el-nikitos/UAH/документация/ИД.png

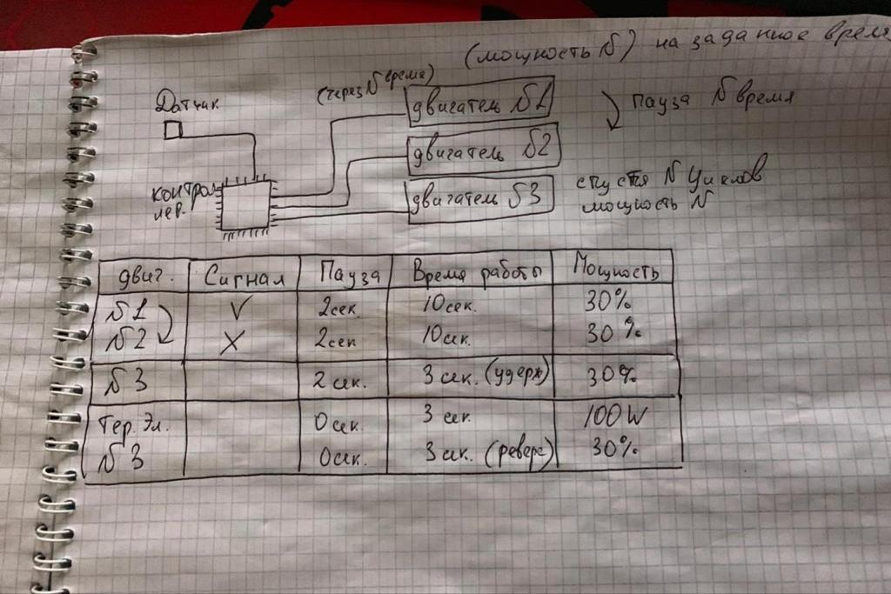
документация/ИД.png
