el-nikitos/UAH/UAH_0/PNG/UAH_0A_B.png

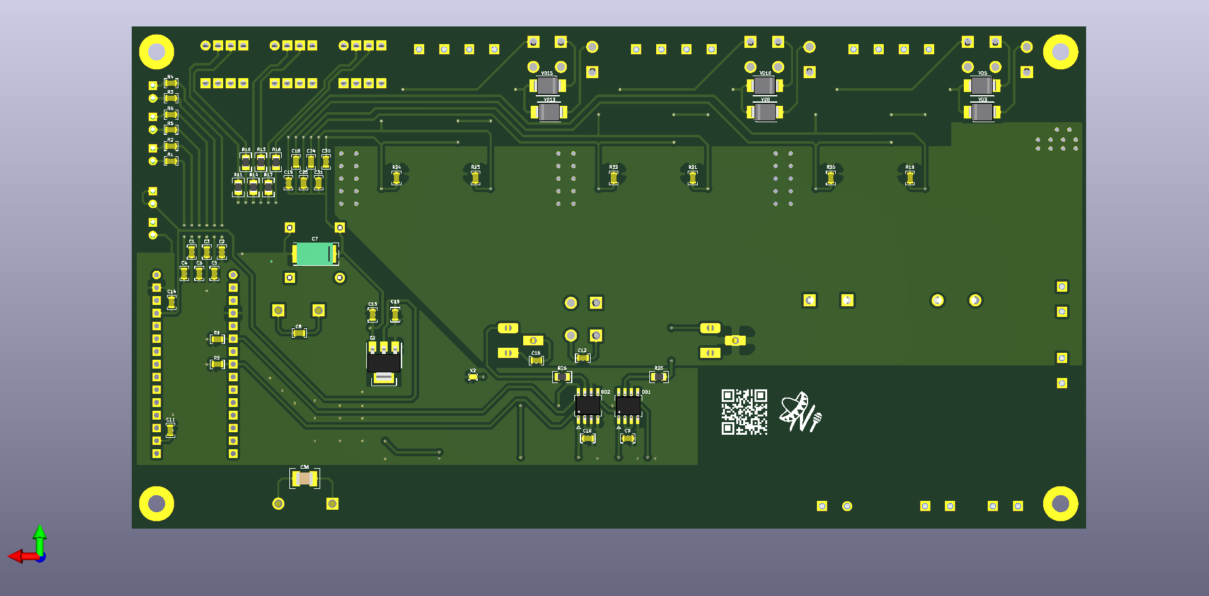
UAH_0/PNG/UAH_0A_B.png
