el-nikitos/UAH/UAH_0/PNG/UAH_0A_F.png

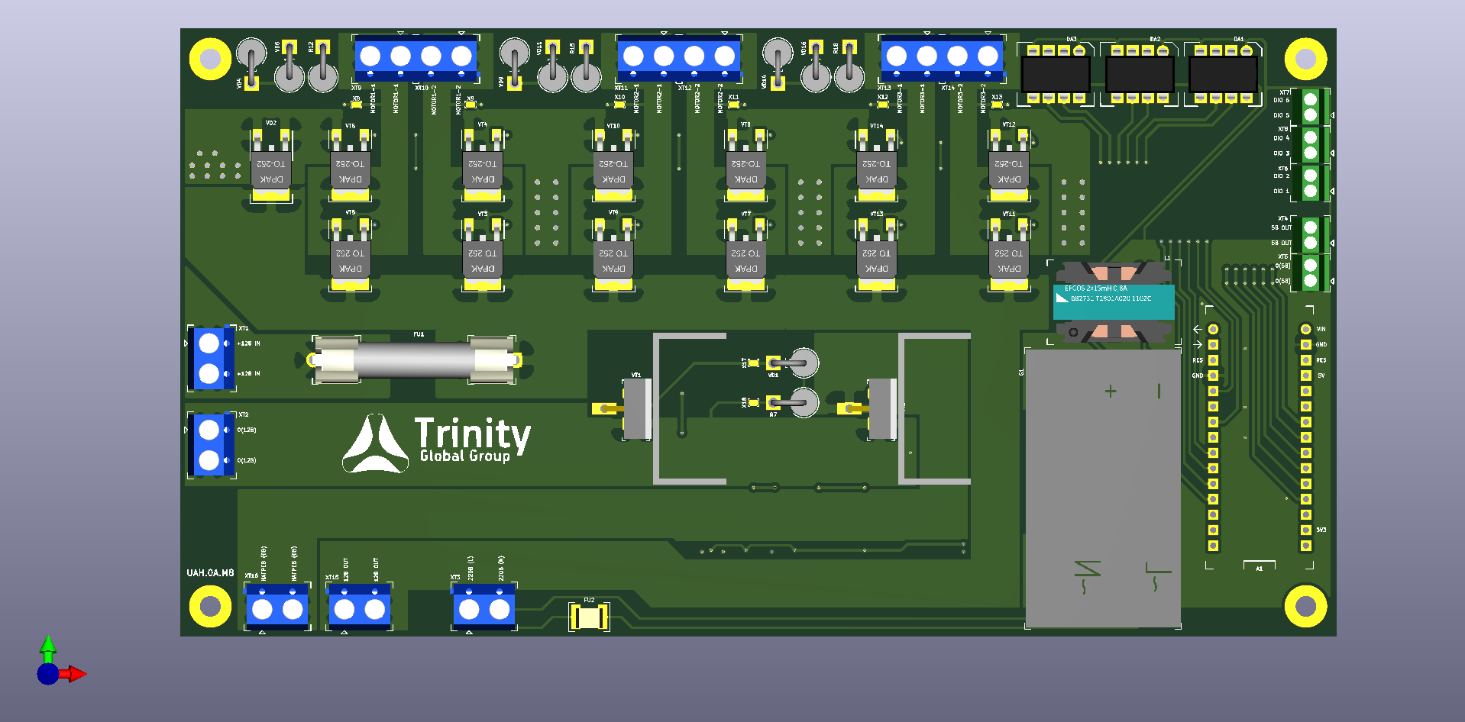
UAH_0/PNG/UAH_0A_F.png
