el-nikitos/UAH/UAH_0/PDF/UAH_0B.pdf

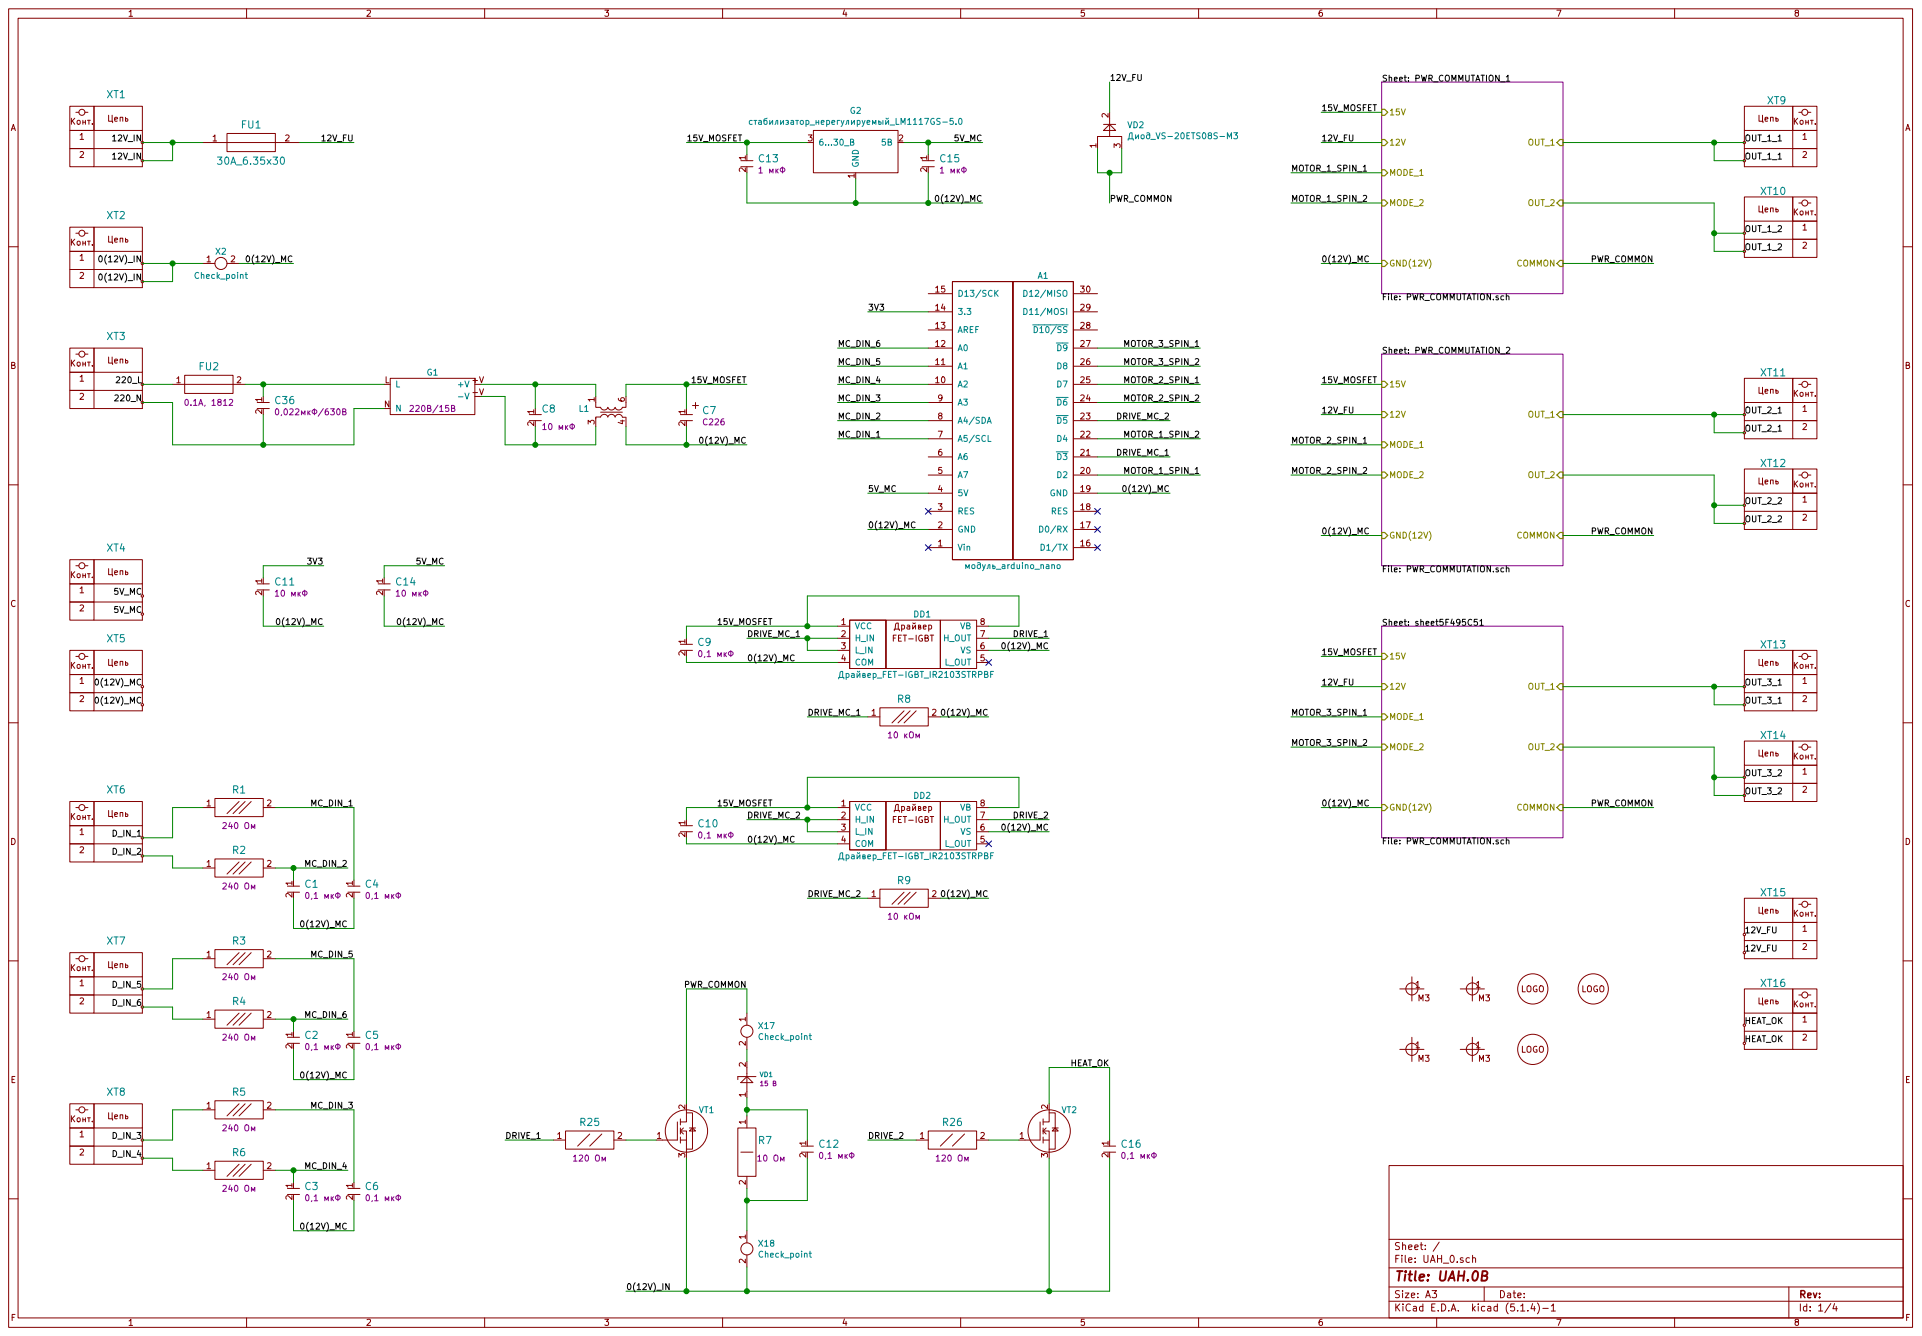
[picture p4: page 1]

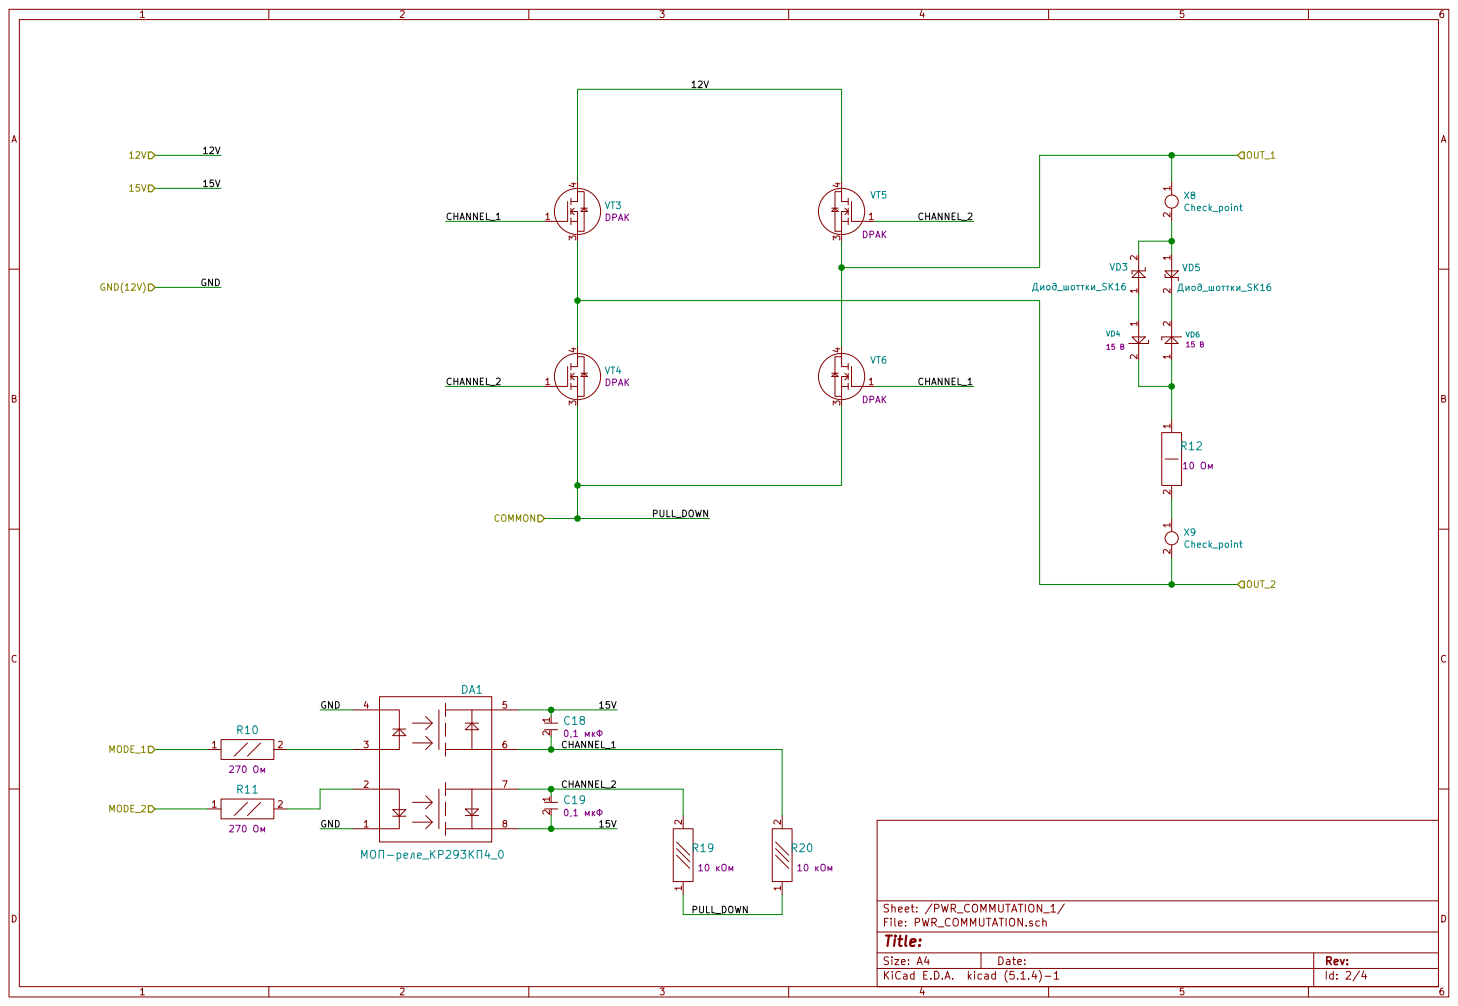
[picture p5: page 2]

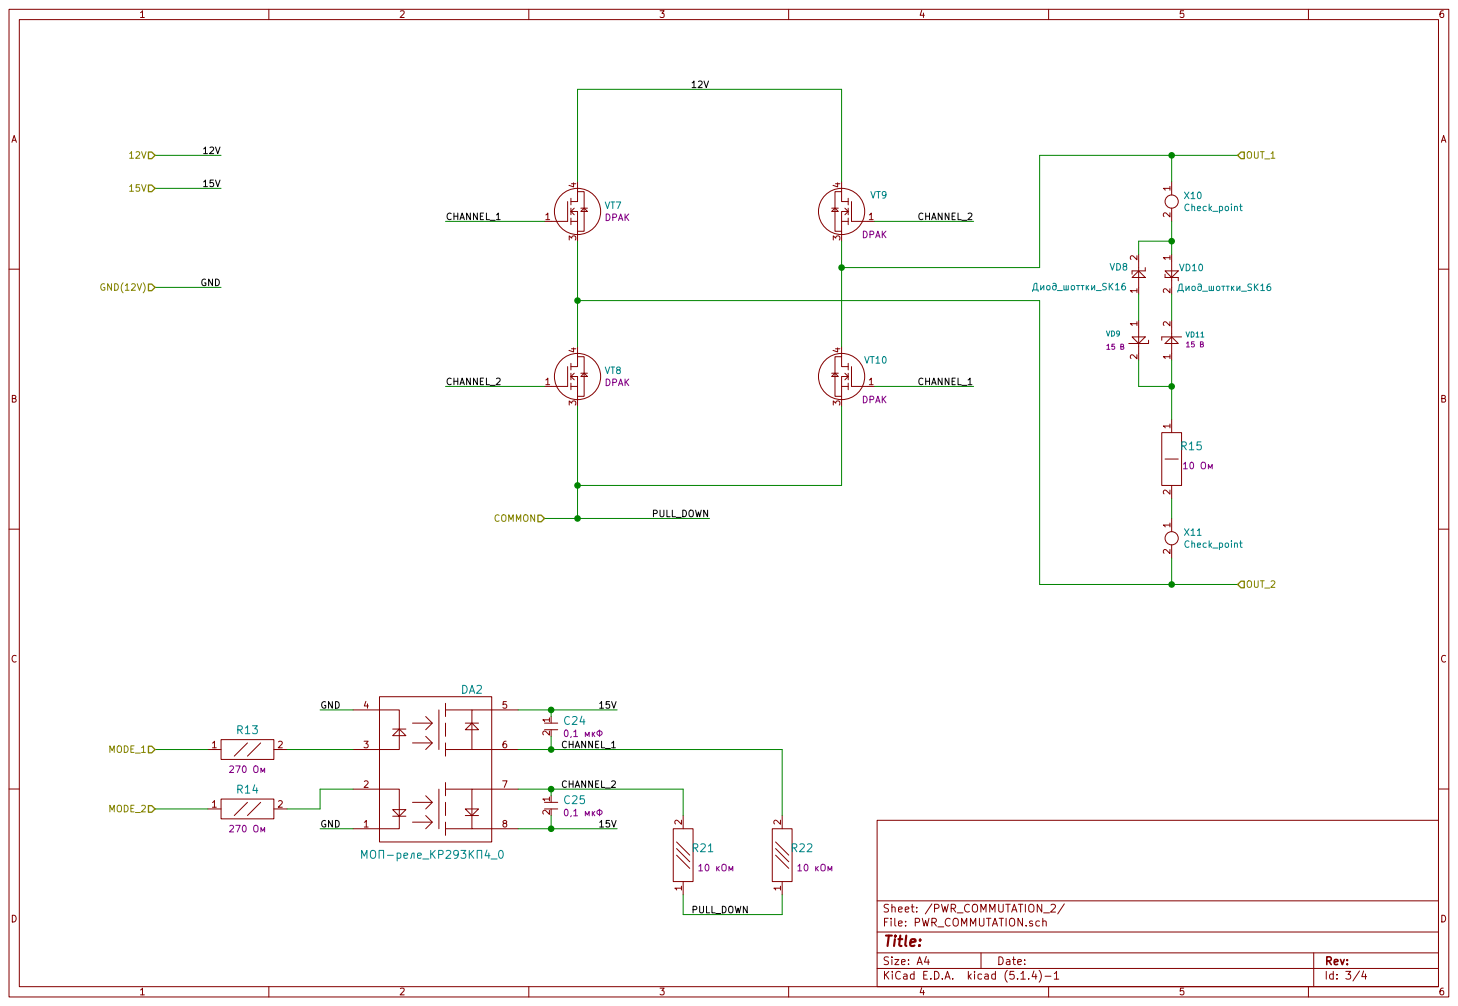
[picture p6: page 3]

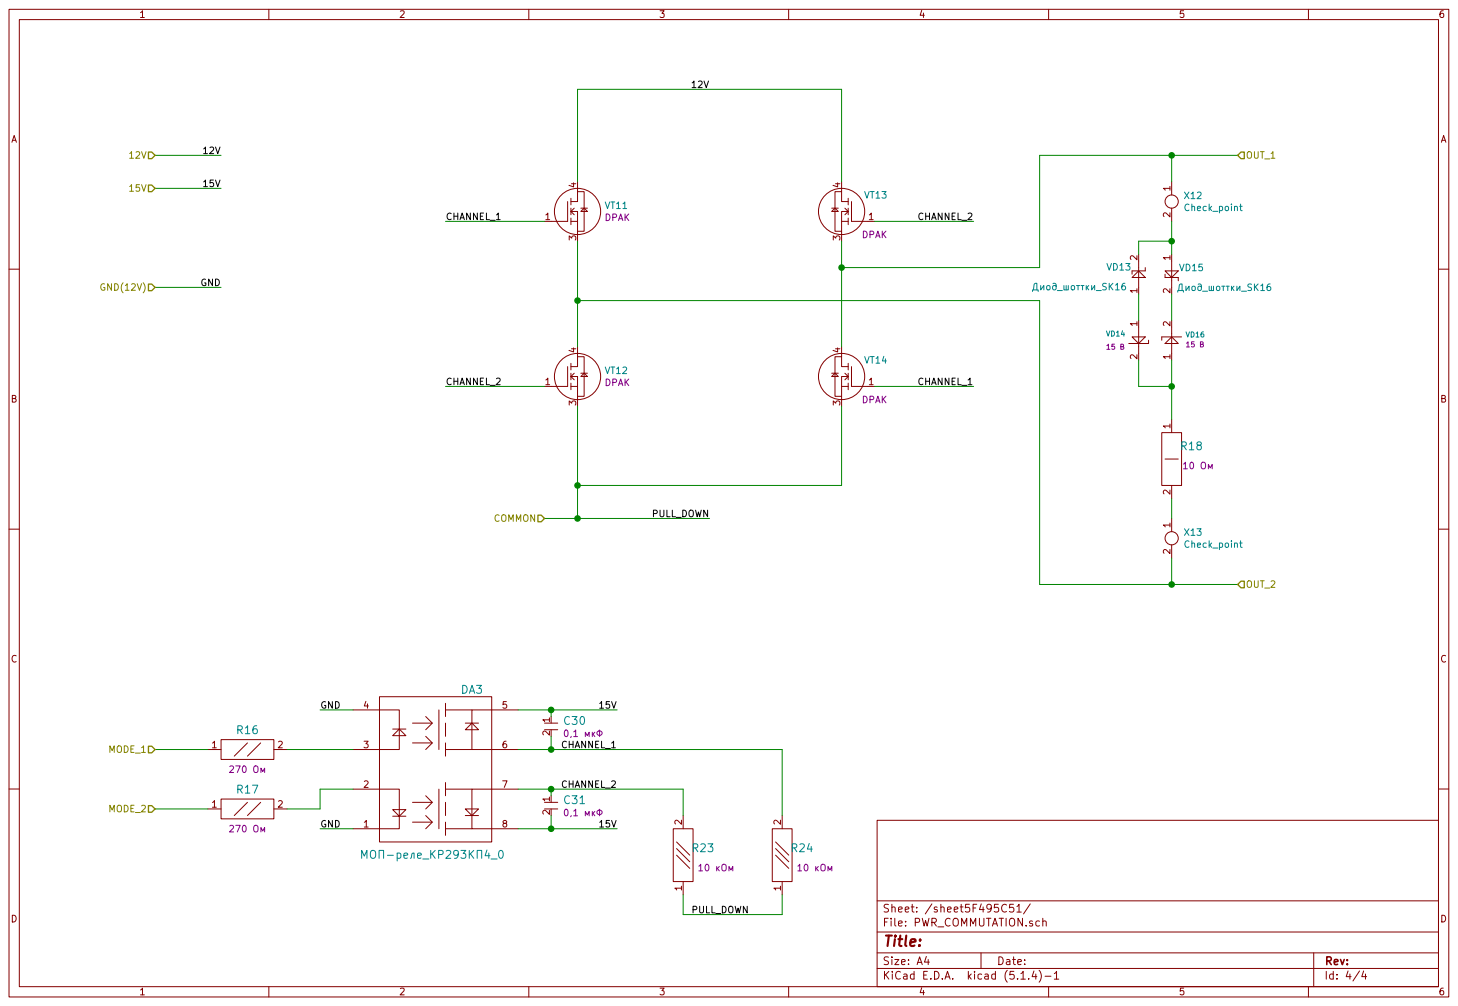
[picture p7: page 4]
