el-nikitos/UAH/UAH_0/PDF/UAH_0A.pdf

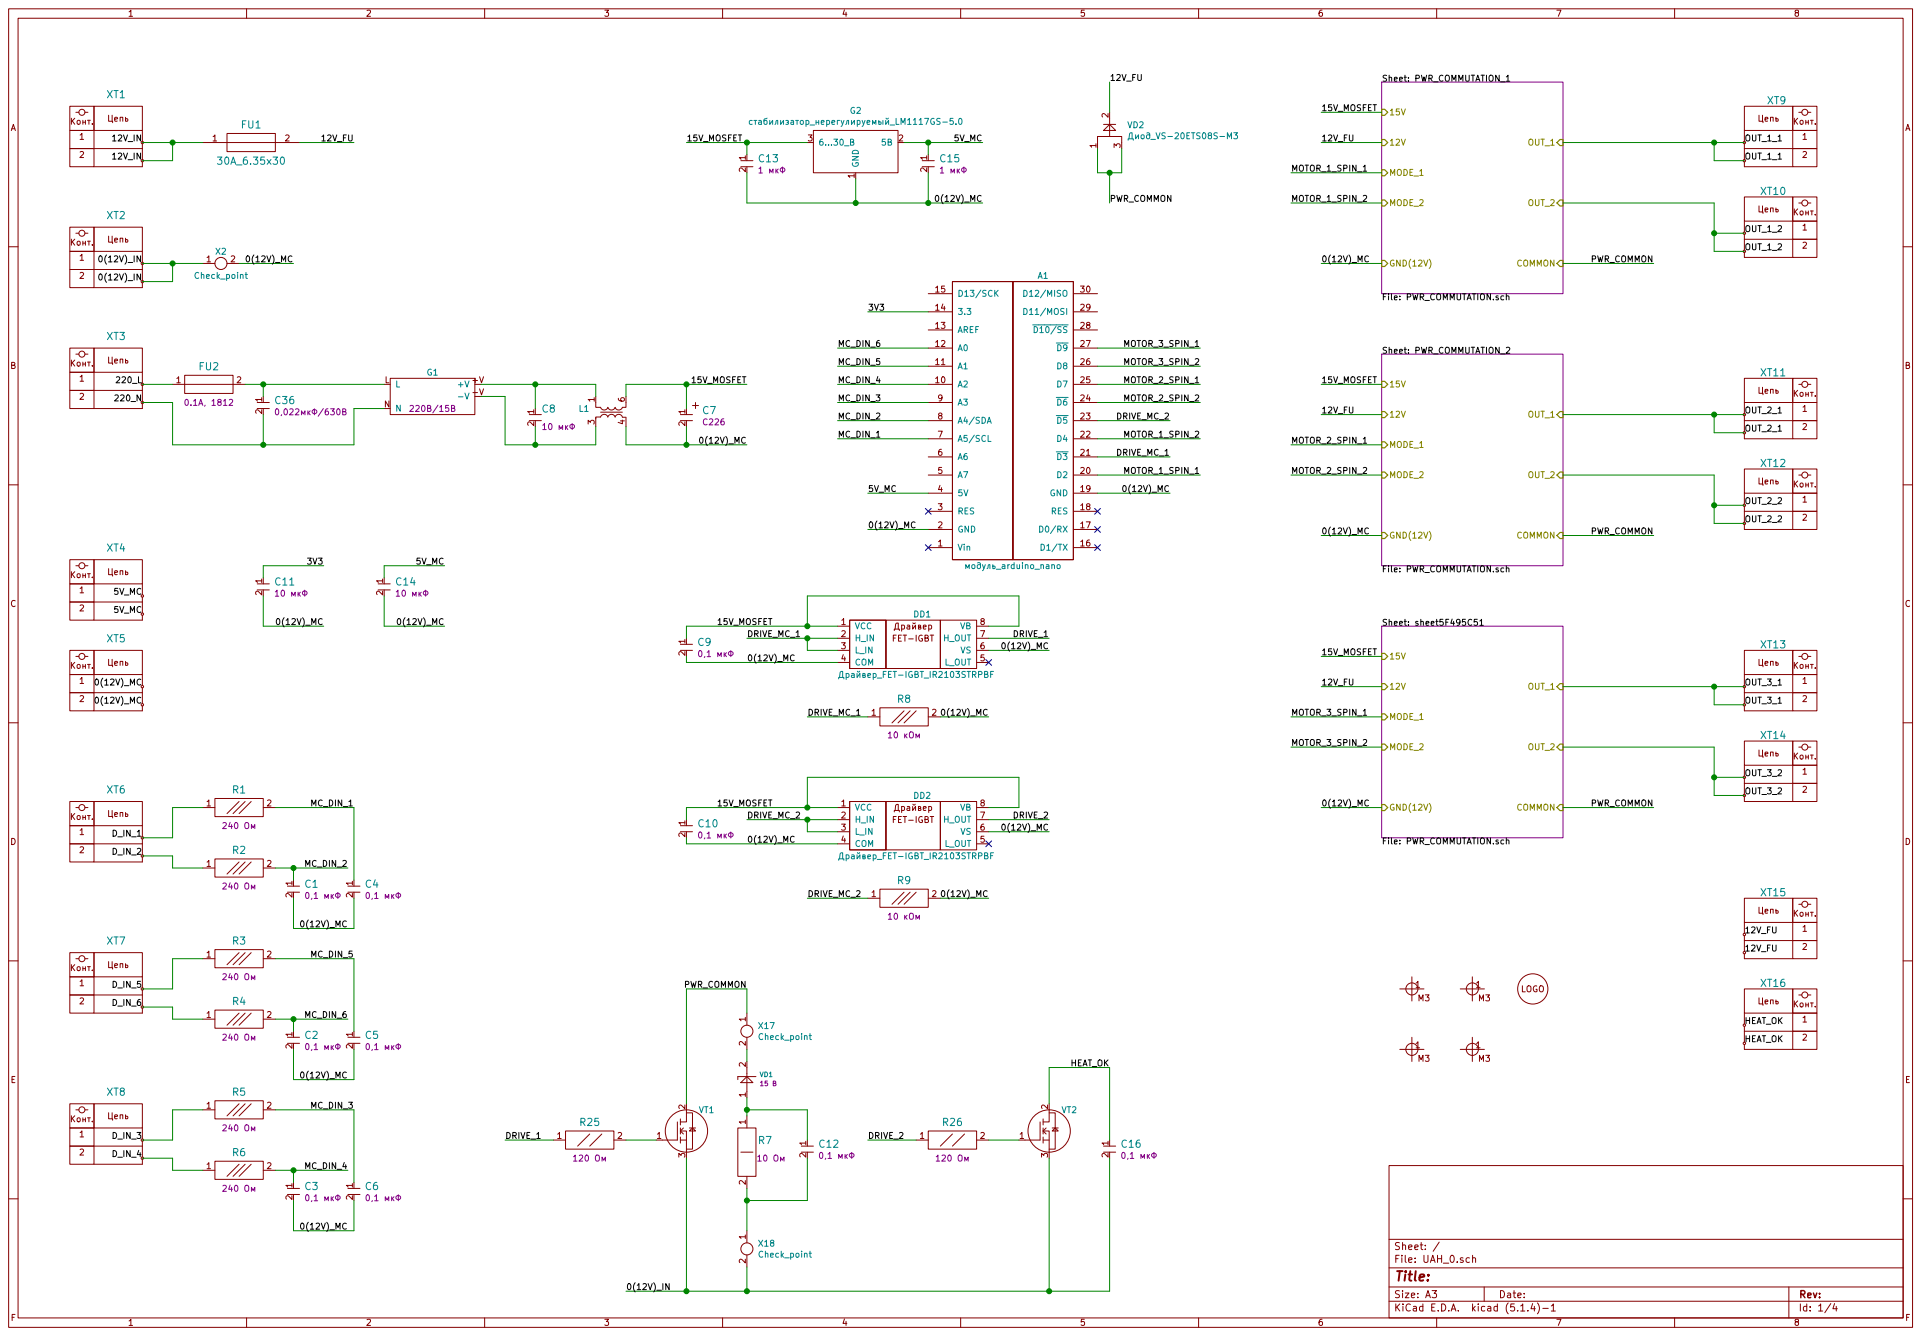
[picture p8: page 1]
