el-nikitos/UAH/UAH_0/UAH_0.kicad_pcb

## KiCad design UAH_0/UAH_0.kicad_pcb (2020-08-16)

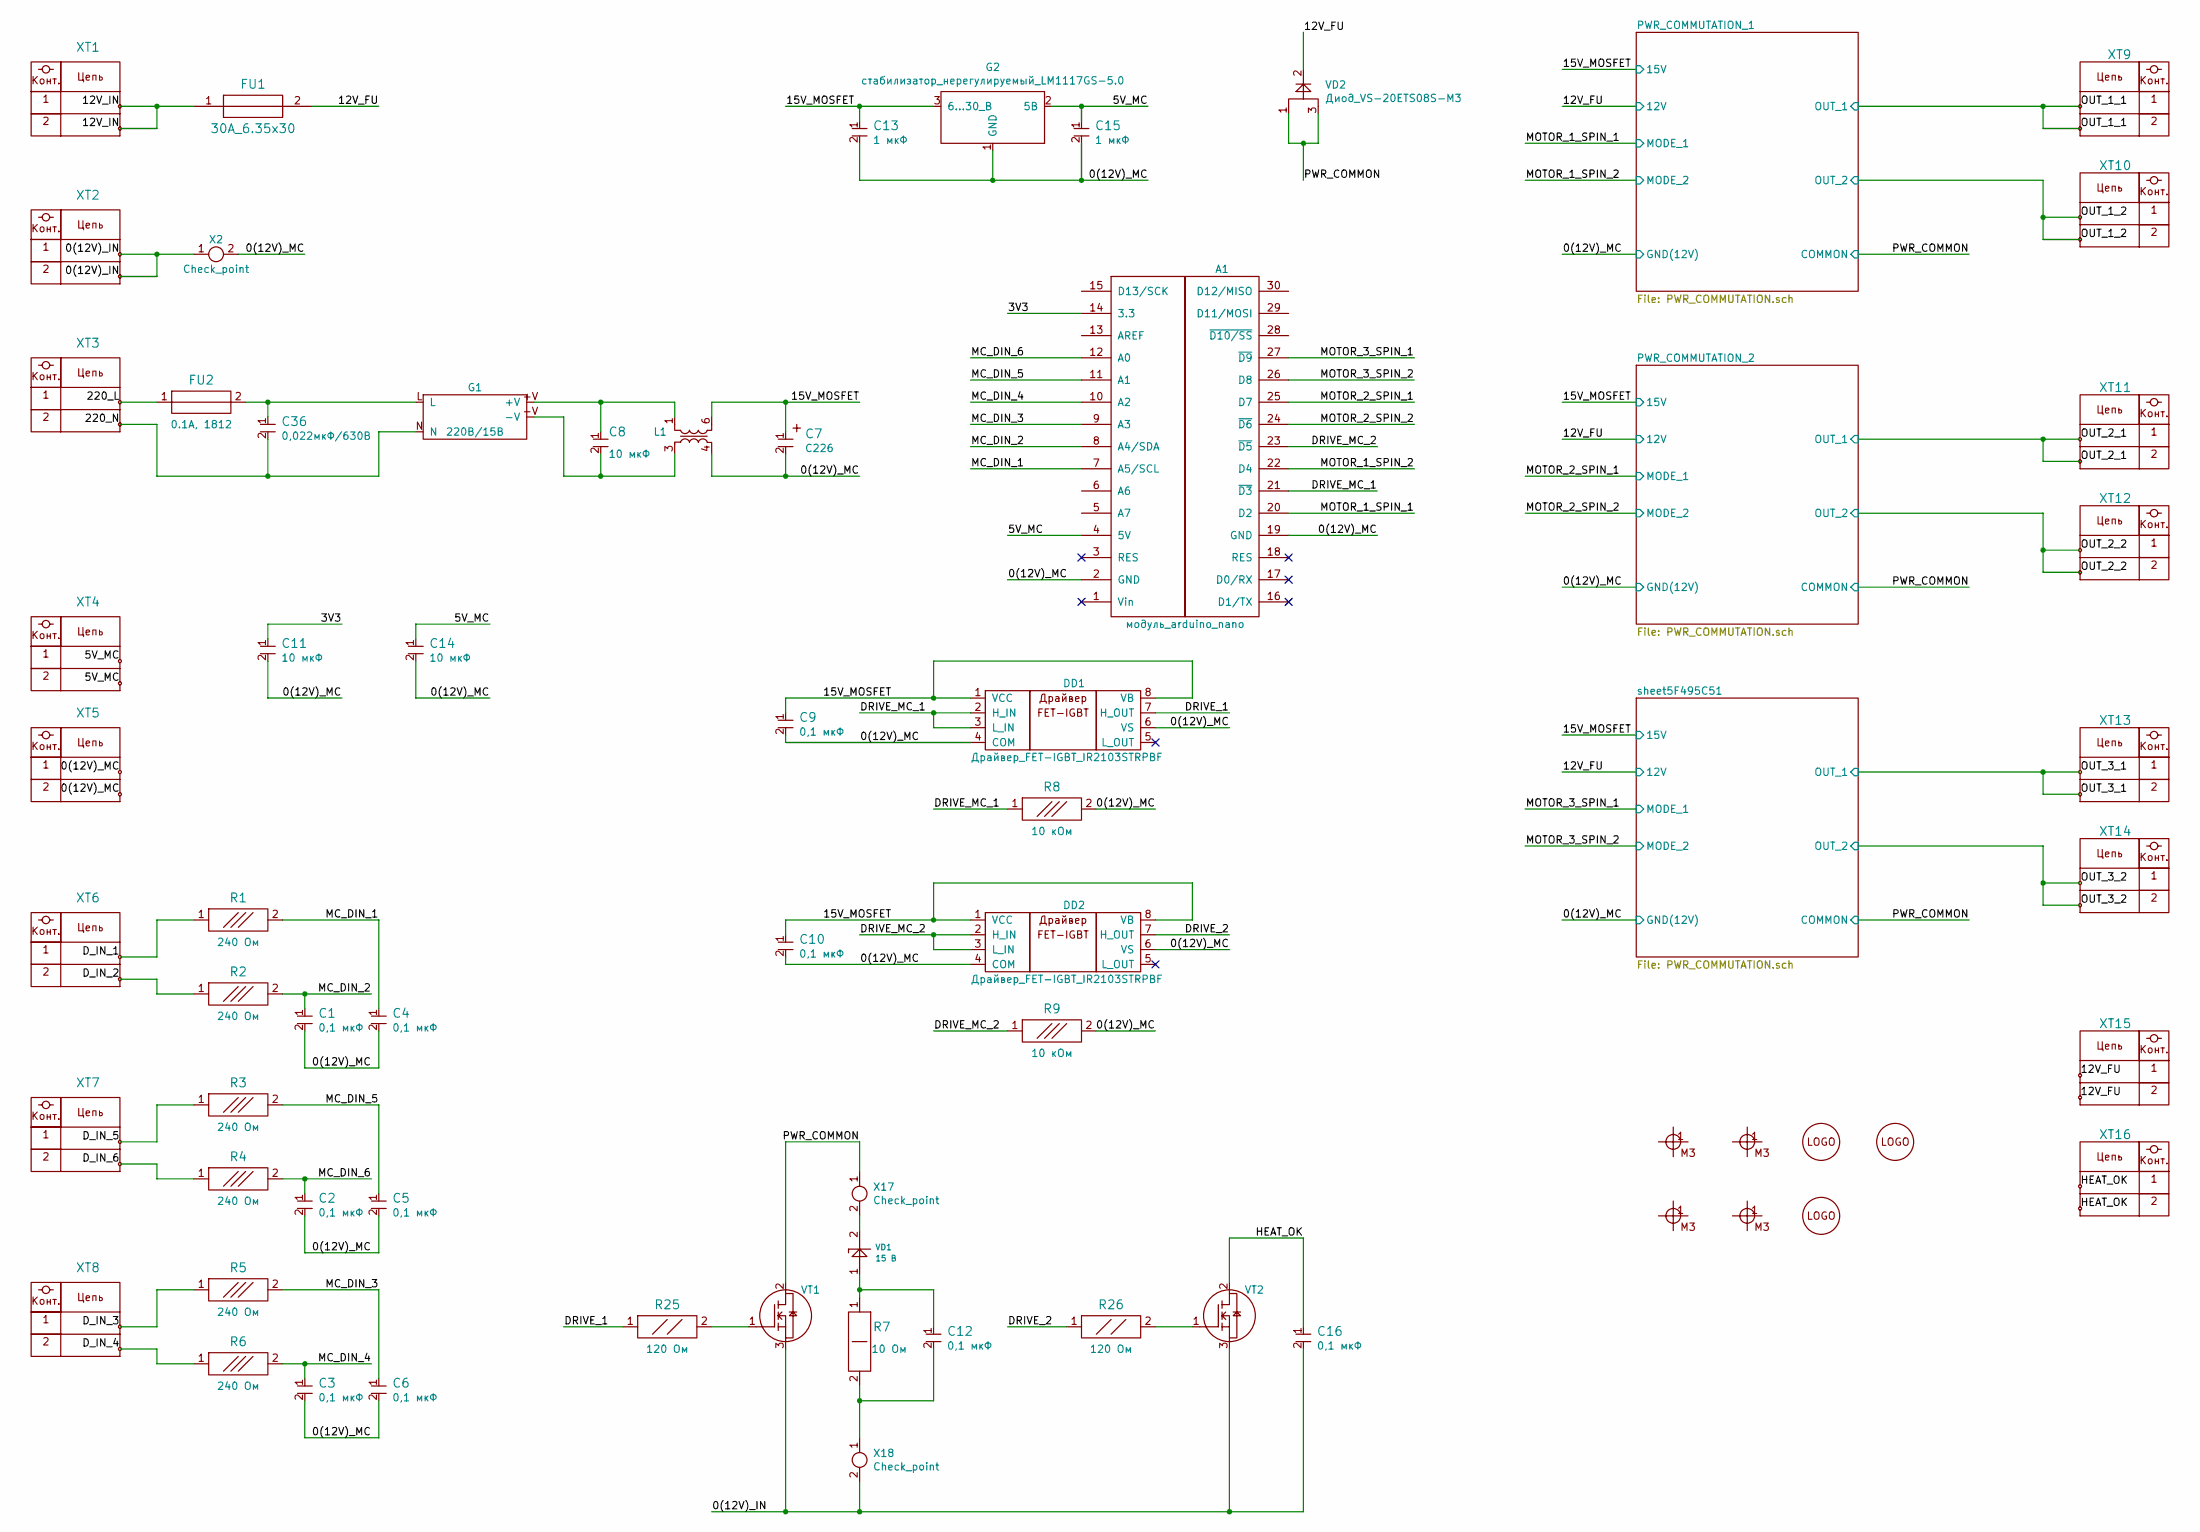
[picture p9: schematic UAH_0.sch, UAH.0B]

Parts:
A1: модуль_arduino_nano; Arduino_nano
C1, C2, C3, C4, C5, C6, C9, C10, C11, C12, C16: Конденсатор_16В_0.1_мкФ+-10проц.; Конденсатор_SMD_К10-83(0603)
C7: Конденсатор_К53-56А-32В-22_мкФ+-10проц.; Конденсатор_тантал_SMD_m7343
C8, C13, C14, C15: Конденсатор_16В_10_мкФ+-10проц.; Конденсатор_SMD_К10-83(0603)
C36: Конденсатор_0.022мкФ_10проц_630В_1210; Конденсатор_SMD_1210
DD1, DD2: Драйвер_FET-IGBT_IR2103STRPBF; SO-8
FU1: 30А_6.35х30; Предохранитель_6.35x30
FU2: Предохранитель_MF-MSMF010_0,1А_1812; Предохранитель_SMD_1812
G1: AC-DC-преобразователь_IRM-10-15; AC-DC_IRM-10-15
G2: стабилизатор_нерегулируемый_LM1117GS-5.0; Транзистор_NPN_SOT223
L1: Дроссель_B82731-T2451-A20_2х47мГн_0.45А_250В; Дроссель_B82731
R1, R2, R3, R4, R5, R6: Резистор_Р1-12-0,1_ум.-240_Ом±5%-Н-«А»; Резистор_SMD_0603-0,075_Вт
R7: Резистор_CF-100_10_Ом_1Вт; резистор_C1-4-1_Вт_вертикальный
R8, R9: Резистор_10_кОм±5%_0,1Вт; Резистор_SMD_0603-0,075_Вт
R25, R26: Резистор_Р1-12-0,125-120_Ом±5%-Н-«А»; Резистор_SMD_0805_0,125Вт
VD1: Стабилитрон_1N5352BRLG_вертикальный; стабилитрон_DO-201_вертикальный
VD2: Диод_VS-20ETS08S-M3; Транзистор_N-канал_dpak
VT1, VT2: MOSFET_N-канал_AUIRF3205Z; Транзистор_TO-220_COOLING
X1: LOGO_NIKITOS_19х7; trinity_32x10
X2, X17, X18: Check_point; Пробник
X3, X4, X5, X6: Крепежное_отверстие_М3; Крепежное_Отверстие_под_М3
X7: LOGO_NIKITOS_19х7; ni_10x10
X14: LOGO_NIKITOS_19х7; El-nikitos_QR_10x10
XT1, XT2, XT3, XT9, XT10, XT11, XT12, XT13, XT14, XT15, XT16: Клеммник_х2_KLS2-300-5.00-02P-2S; Клеммник_х2_шаг5
XT4, XT5, XT6, XT7, XT8: Клеммник_х2_KLS2-300-5.00-02P-2S; Клеммник_х2_шаг2.54

Connections:
/0(12V)_IN: C16.2, VT1.3, VT2.3, X2.1, X18.2, XT2.1, XT2.2
/0(12V)_MC: A1.2 (GND), A1.19 (GND), C1.2, C2.2, C3.2, C4.2, C5.2, C6.2, C7.2, C9.2, C10.2, C11.2, C13.2, C14.2, C15.2, DD1.4 (COM), DD1.6 (VS), DD2.4 (COM), DD2.6 (VS), G2.1 (GND), L1.4, R8.2, R9.2, X2.2, XT5.1, XT5.2; also elsewhere on the board
/3V3: A1.14 (3.3), C11.1
/5V_MC: A1.4 (5V), C14.1, C15.1, G2.2 (5В), XT4.1, XT4.2
/12V_FU: FU1.2, VD2.2, XT15.1, XT15.2; also elsewhere on the board
/12V_IN: FU1.1, XT1.1, XT1.2
/15V_MOSFET: C7.1, C9.1, C10.1, C13.1, DD1.1 (VCC), DD1.8 (VB), DD2.1 (VCC), DD2.8 (VB), G2.3 (6...30_В), L1.6; also elsewhere on the board
/220_L: FU2.1, XT3.1
/220_N: C36.2, G1.N, XT3.2
/DRIVE_1: DD1.7 (H_OUT), R25.1
/DRIVE_2: DD2.7 (H_OUT), R26.1
/DRIVE_MC_1: A1.21 (~D3), DD1.2 (H_IN), DD1.3 (L_IN), R8.1
/DRIVE_MC_2: A1.23 (~D5), DD2.2 (H_IN), DD2.3 (L_IN), R9.1
/D_IN_1: R1.1, XT6.1
/D_IN_2: R2.1, XT6.2
/D_IN_3: R5.1, XT8.1
/D_IN_4: R6.1, XT8.2
/D_IN_5: R3.1, XT7.1
/D_IN_6: R4.1, XT7.2
/HEAT_OK: C16.1, VT2.2, XT16.1, XT16.2
/MC_DIN_1: A1.7 (A5/SCL), C4.1, R1.2
/MC_DIN_2: A1.8 (A4/SDA), C1.1, R2.2
/MC_DIN_3: A1.9 (A3), C6.1, R5.2
/MC_DIN_4: A1.10 (A2), C3.1, R6.2
/MC_DIN_5: A1.11 (A1), C5.1, R3.2
/MC_DIN_6: A1.12 (A0), C2.1, R4.2
/MOTOR_1_SPIN_1: A1.20 (D2); also elsewhere on the board
/MOTOR_1_SPIN_2: A1.22 (D4); also elsewhere on the board
/MOTOR_2_SPIN_1: A1.25 (D7); also elsewhere on the board
/MOTOR_2_SPIN_2: A1.24 (~D6); also elsewhere on the board
/MOTOR_3_SPIN_1: A1.27 (~D9); also elsewhere on the board
/MOTOR_3_SPIN_2: A1.26 (D8); also elsewhere on the board
/OUT_1_1: XT9.1, XT9.2; also elsewhere on the board
/OUT_1_2: XT10.1, XT10.2; also elsewhere on the board
/OUT_2_1: XT11.1, XT11.2; also elsewhere on the board
/OUT_2_2: XT12.1, XT12.2; also elsewhere on the board
/OUT_3_1: XT13.1, XT13.2; also elsewhere on the board
/OUT_3_2: XT14.1, XT14.2; also elsewhere on the board
/PWR_COMMON: VD2.1, VD2.3, VT1.2, X17.1; also elsewhere on the board
unnamed: C8.1, G1.+V, L1.1
unnamed: C8.2, G1.-V, L1.3
unnamed: C12.1, R7.1, VD1.1
unnamed: C12.2, R7.2, X18.1
unnamed: C36.1, FU2.2, G1.L
unnamed: R25.2, VT1.1
unnamed: R26.2, VT2.1
unnamed: VD1.2, X17.2

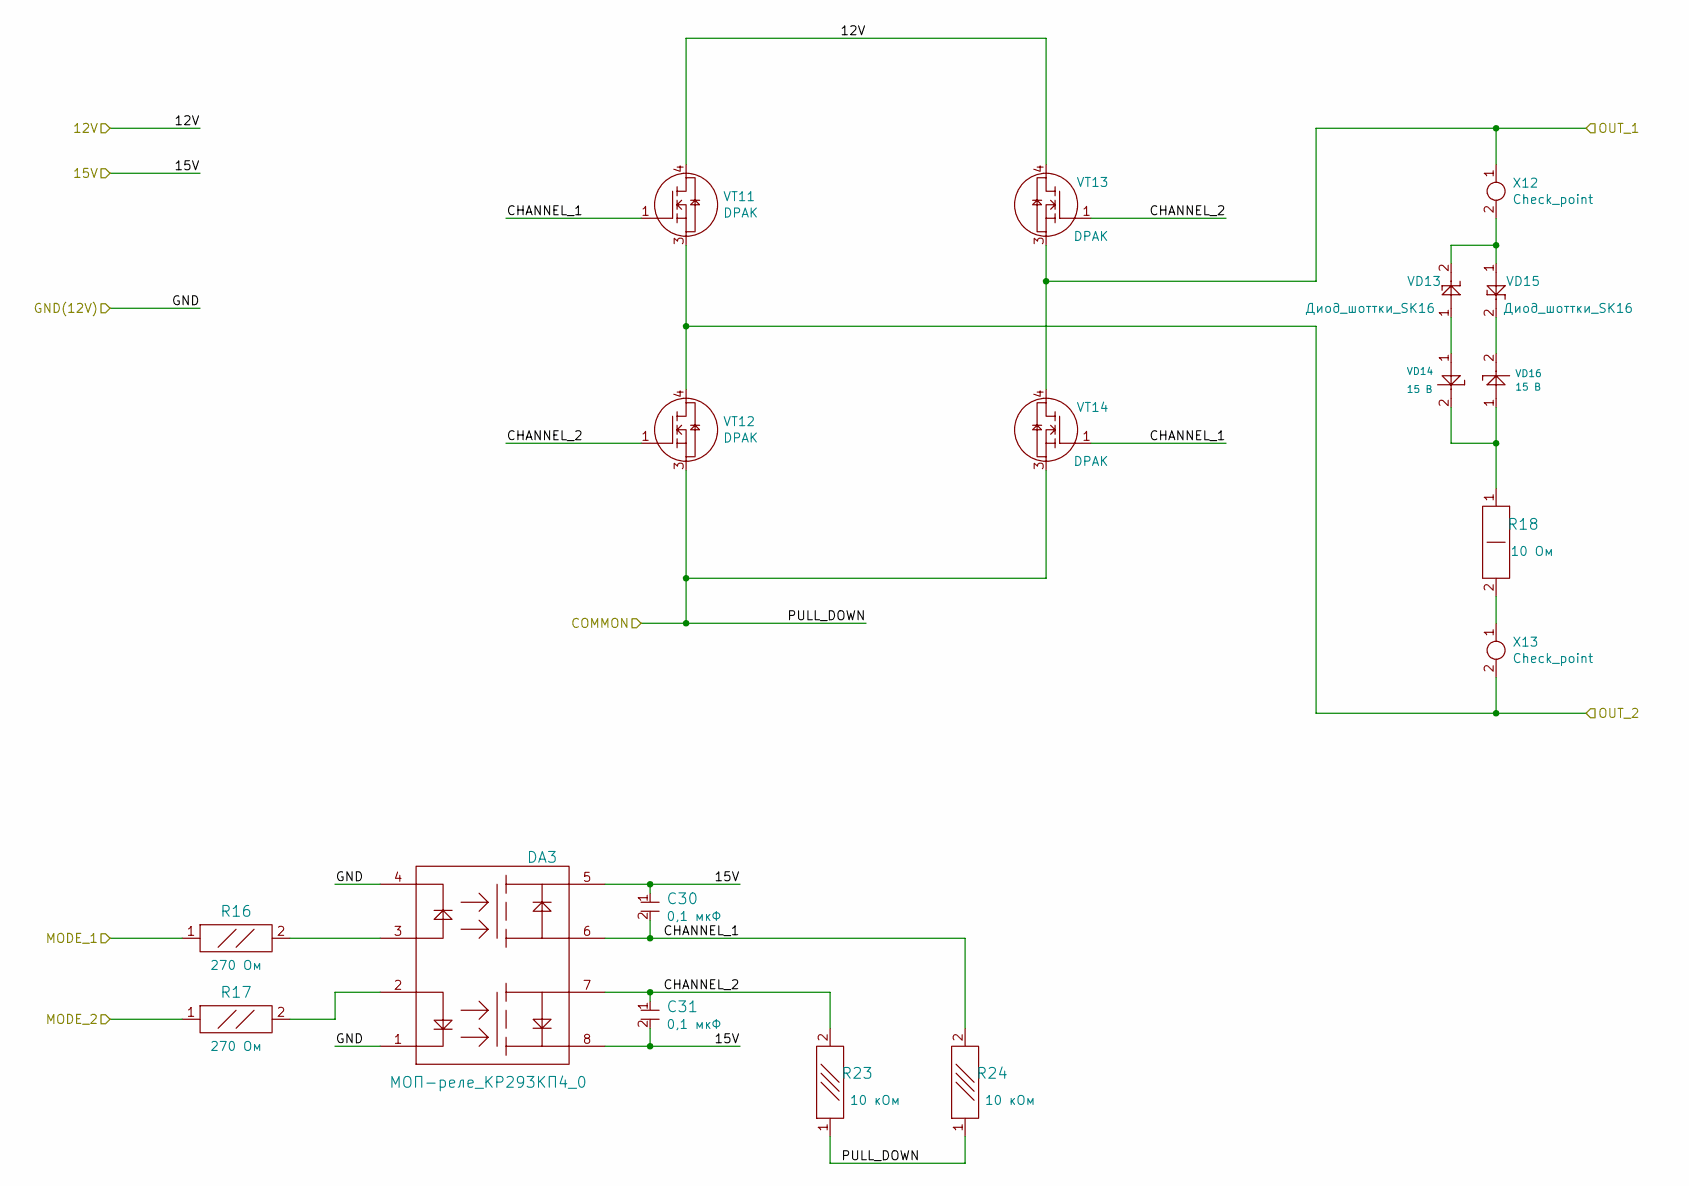
[picture p10: schematic PWR_COMMUTATION.sch]

Parts:
C18, C19: Конденсатор_16В_0.1_мкФ+-10проц.; Конденсатор_SMD_К10-83(0603)
DA1: МОП-реле_КР293КП4_0; DIP8
R10, R11: Резистор_Р1-12-0,125-270_Ом±5%-Н-«А»; Резистор_SMD_0805_0,125Вт
R12: Резистор_CF-100_10_Ом_1Вт; резистор_C1-4-1_Вт_вертикальный
R19, R20: Резистор_10_кОм±5%_0,1Вт; Резистор_SMD_0603-0,075_Вт
VD3, VD5: Диод_шоттки_SK16; Диод_SMB
VD4, VD6: Стабилитрон_1N5352BRLG_вертикальный; стабилитрон_DO-201_вертикальный
VT3, VT4, VT5, VT6: MOSFET_N-канал_STD60N3LH5; IGBT_dpak
X8, X9: Check_point; Пробник

Connections:
/0(12V)_MC: DA1.1, DA1.4; also elsewhere on the board
/12V_FU: VT3.4, VT5.4; also elsewhere on the board
/15V_MOSFET: C18.1, C19.2, DA1.5, DA1.8; also elsewhere on the board
/MOTOR_1_SPIN_1: R10.1; also elsewhere on the board
/MOTOR_1_SPIN_2: R11.1; also elsewhere on the board
/OUT_1_1: VT5.3, VT6.4, X8.1; also elsewhere on the board
/OUT_1_2: VT3.3, VT4.4, X9.2; also elsewhere on the board
/PWR_COMMON: R19.1, R20.1, VT4.3, VT6.3; also elsewhere on the board
/PWR_COMMUTATION_1/CHANNEL_1: C18.2, DA1.6, R20.2, VT3.1, VT6.1
/PWR_COMMUTATION_1/CHANNEL_2: C19.1, DA1.7, R19.2, VT4.1, VT5.1
unnamed: DA1.2, R11.2
unnamed: DA1.3, R10.2
unnamed: R12.1, VD4.2, VD6.1
unnamed: R12.2, X9.1
unnamed: VD3.1, VD4.1
unnamed: VD3.2, VD5.1, X8.2
unnamed: VD5.2, VD6.2

Parts of its further copies:
C24, C25, C30, C31: Конденсатор_16В_0.1_мкФ+-10проц.; Конденсатор_SMD_К10-83(0603)
DA2, DA3: МОП-реле_КР293КП4_0; DIP8
R13, R14, R16, R17: Резистор_Р1-12-0,125-270_Ом±5%-Н-«А»; Резистор_SMD_0805_0,125Вт
R15, R18: Резистор_CF-100_10_Ом_1Вт; резистор_C1-4-1_Вт_вертикальный
R21, R22, R23, R24: Резистор_10_кОм±5%_0,1Вт; Резистор_SMD_0603-0,075_Вт
VD8, VD10, VD13, VD15: Диод_шоттки_SK16; Диод_SMB
VD9, VD11, VD14, VD16: Стабилитрон_1N5352BRLG_вертикальный; стабилитрон_DO-201_вертикальный
VT7, VT8, VT9, VT10, VT11, VT12, VT13, VT14: MOSFET_N-канал_STD60N3LH5; IGBT_dpak
X10, X11, X12, X13: Check_point; Пробник

Connections of its further copies:
/0(12V)_MC: DA2.1, DA2.4, DA3.1, DA3.4; also elsewhere on the board
/12V_FU: VT7.4, VT9.4, VT11.4, VT13.4; also elsewhere on the board
/15V_MOSFET: C24.1, C25.2, C30.1, C31.2, DA2.5, DA2.8, DA3.5, DA3.8; also elsewhere on the board
/MOTOR_2_SPIN_1: R13.1; also elsewhere on the board
/MOTOR_2_SPIN_2: R14.1; also elsewhere on the board
/MOTOR_3_SPIN_1: R16.1; also elsewhere on the board
/MOTOR_3_SPIN_2: R17.1; also elsewhere on the board
/OUT_2_1: VT9.3, VT10.4, X10.1; also elsewhere on the board
/OUT_2_2: VT7.3, VT8.4, X11.2; also elsewhere on the board
/OUT_3_1: VT13.3, VT14.4, X12.1; also elsewhere on the board
/OUT_3_2: VT11.3, VT12.4, X13.2; also elsewhere on the board
/PWR_COMMON: R21.1, R22.1, R23.1, R24.1, VT8.3, VT10.3, VT12.3, VT14.3; also elsewhere on the board
/PWR_COMMUTATION_2/CHANNEL_1: C24.2, DA2.6, R22.2, VT7.1, VT10.1
/PWR_COMMUTATION_2/CHANNEL_2: C25.1, DA2.7, R21.2, VT8.1, VT9.1
/sheet5F495C51/CHANNEL_1: C30.2, DA3.6, R24.2, VT11.1, VT14.1
/sheet5F495C51/CHANNEL_2: C31.1, DA3.7, R23.2, VT12.1, VT13.1
unnamed: DA2.2, R14.2
unnamed: DA2.3, R13.2
unnamed: DA3.2, R17.2
unnamed: DA3.3, R16.2
unnamed: R15.1, VD9.2, VD11.1
unnamed: R15.2, X11.1
unnamed: R18.1, VD14.2, VD16.1
unnamed: R18.2, X13.1
unnamed: VD8.1, VD9.1
unnamed: VD8.2, VD10.1, X10.2
unnamed: VD10.2, VD11.2
unnamed: VD13.1, VD14.1
unnamed: VD13.2, VD15.1, X12.2
unnamed: VD15.2, VD16.2

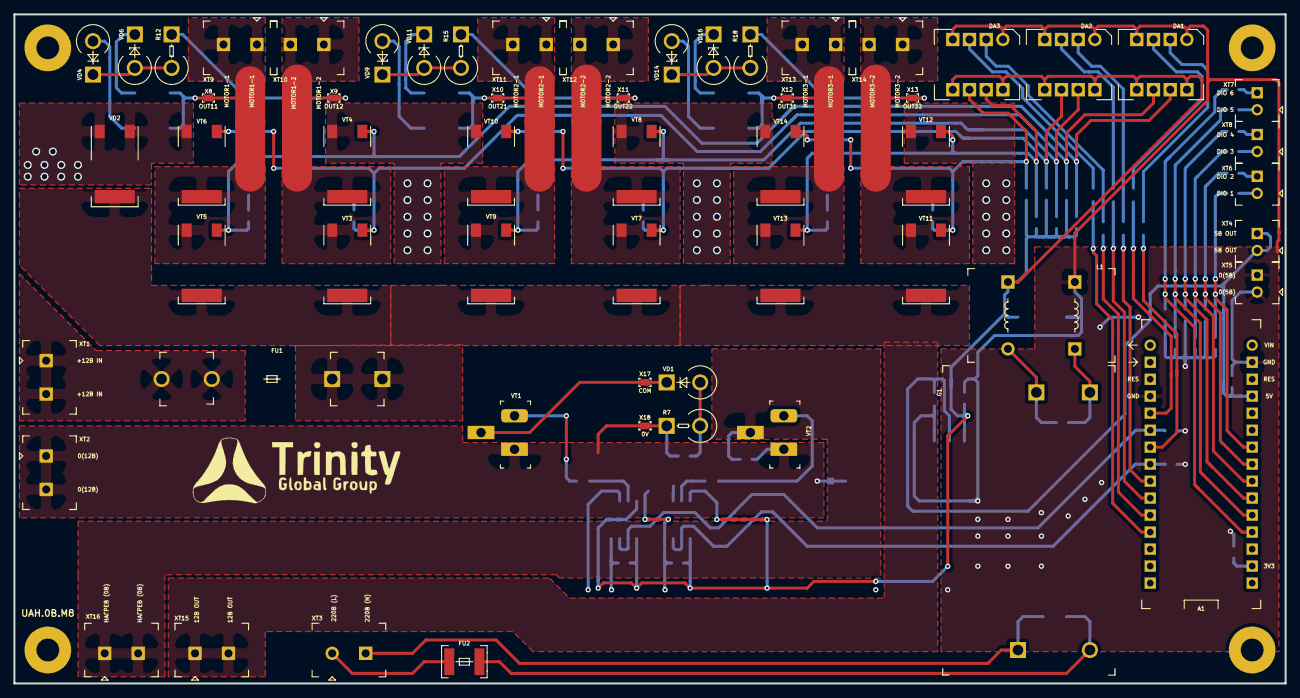
[picture p11: board UAH_0.kicad_pcb from above]

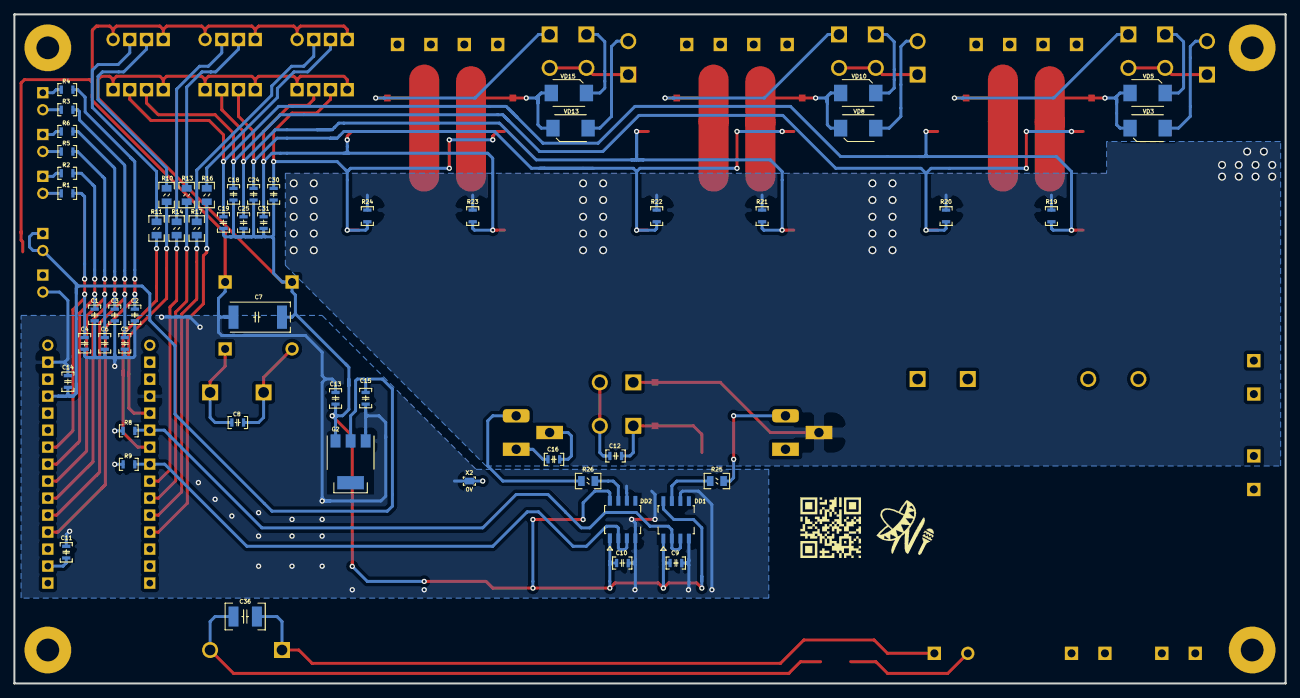
[picture p12: board UAH_0.kicad_pcb from below]

Board: 2 copper layers, 190.0 x 100.0 mm, 120 parts (57 on the bottom side), 74 nets.
