el-nikitos/UAH/(commit log)

2020-08-06 Драйвер двигателя и нагревателя
2020-08-08 начата схема, не решен вопрос с драйверами, много УГО надо нарисовать
    [PWR_COMMUTATION.sch, UAH_0.kicad_pcb, UAH_0.sch]
2020-08-09 обновлена схема управления движками
    [PWR_COMMUTATION.sch, UAH_0.kicad_pcb, UAH_0.sch]
2020-08-12 закончена принципиальная схема, подготовлен мост и обвес на 1й канал
    [PWR_COMMUTATION.sch, UAH_0.kicad_pcb, UAH_0.sch]
2020-08-13 расставлена силовая часть на 3 канала, нет управления и главных ключей
    [PWR_COMMUTATION.sch, UAH_0.kicad_pcb, UAH_0.sch]
2020-08-15 не подведены управления DI, габарит определен
    [PWR_COMMUTATION.sch, UAH_0.kicad_pcb, UAH_0.sch]
2020-08-16 закончена трассировка, надо добавить лого и маркировка, PDF обновлен
    [UAH_0.kicad_pcb, UAH_0.sch]
2020-08-16 добавлена маркировка, обновлены STEP, PDF, PNG, нет ЛОГО заказчика
    [UAH_0.kicad_pcb, UAH_0.sch]
2020-08-16 UAH_0B, готова плата +gerbers
    [PWR_COMMUTATION.sch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]
2020-08-16 в схеме отражены позиции для BOM
    [PWR_COMMUTATION.sch, UAH_0.sch]
2020-08-26 arduino - проверка функционирования
2020-08-26 за-define-ны ножки DIO
2020-08-31 ПО на комп
    подготовлено меню выбора последовательного порта, нужно добавить функционал кнопкам и добавить сетку выбора параметров
2020-09-01 ver.A0.1.M9 добавлен фокус на кнопки
2020-09-04 ver.A0.2.M9 добавлена сетка для ввода значений
2020-09-04 добавлены действия с полями и пояснения к областям рабочего поля
2020-09-05 ver.A0.4.M9 добавлена загрузка и сохранение параметров через json
2020-09-05 небольшие исправления в интерфейсе, заготовлен документ Тех. Описание
    [UAH_PC.pde, class_InputBox.pde, threads_for_buttons.pde]
2021-02-21 исправления в прошивке
